MisterTi836/Voiture_commandes_gestuelles/README.md

# Voiture_commandes_gestuelles
Voiture télécommandé, controlé par des commandes gestuelles en Arduino
