MisterTi836/Voiture_commandes_gestuelles/Compte-rendus/Thibault GARROT/Rapport du 13-01.pdf

## Rapport du 13/01/2020 :

- Fin de l’initialisation des deux modules bluetooths.
Le HC-06 étant déjà configurer, je me suis chargé de paramétrer le HC-05.

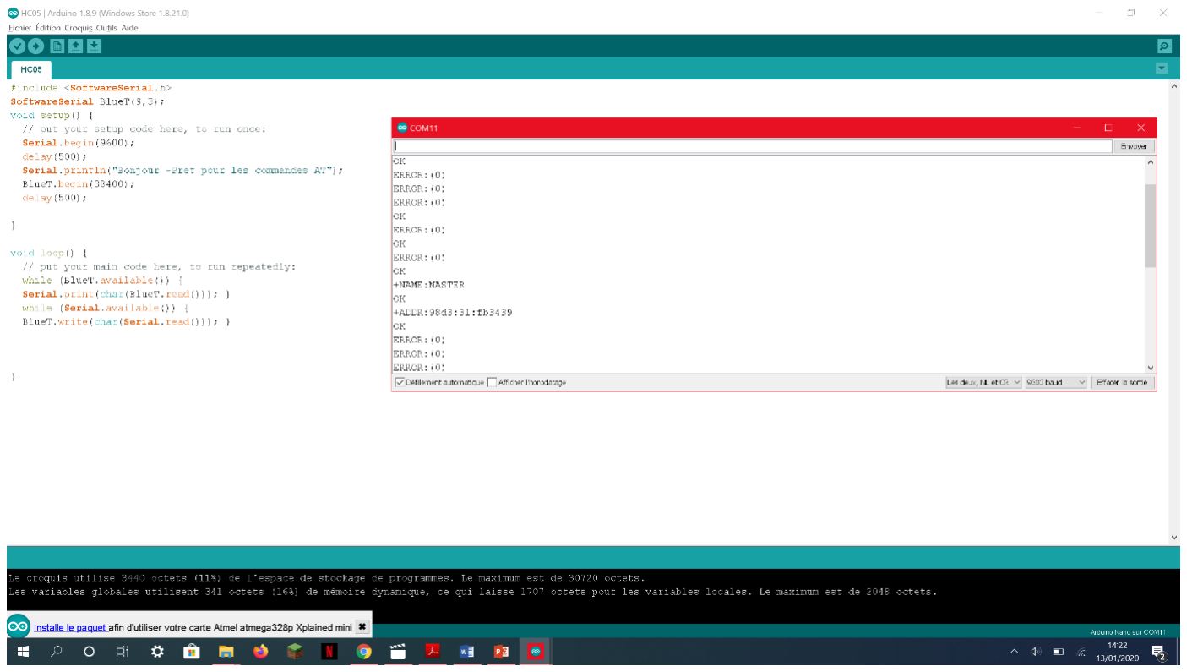
[picture p1: figure]

Code HC-05 initialisation.

- Problème pour la puissance des moteurs, les roues ne tournent pas assez vite. Test changement de piles et test du programme inefficace sur le problème. Devrait-on prendre des moteurs plus puissants ?

- Réalisation du programme de l’accéléromètre pour récupérer la valeur des angles sur x,y,z. J’ai pu calculer les angles sur les trois axes dans mon programme pour ensuite les afficher dans le moniteur série et pour ainsi tester les angles que me retourner l’accéléromètre. J’ai donc établi les 6 conditions d’angles nécessaires au déplacement de notre voiture avec le gant (décrit sur la feuille ci-dessous). Ces conditions pourront être améliorer pour établir des mouvements progressifs (accélération progressive etc…)

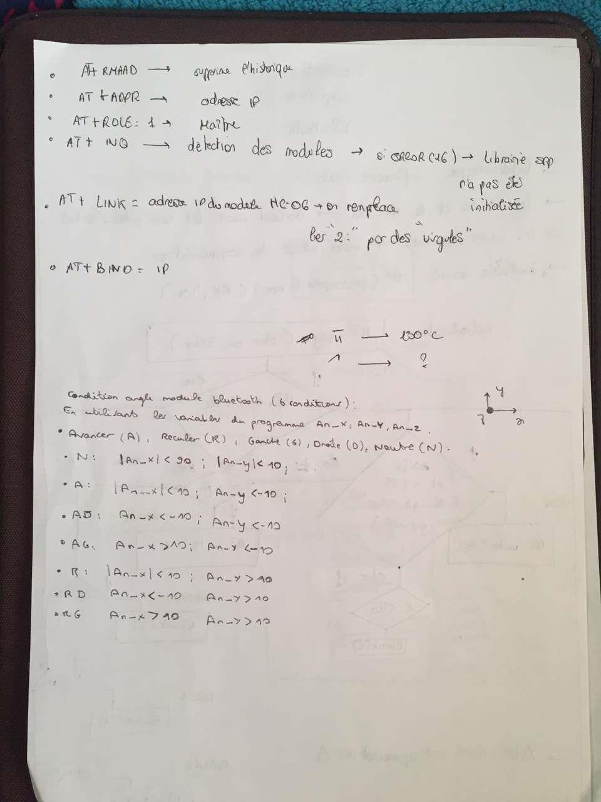
[picture p2: figure]

Tsiory lui s’est occupé principalement des algorithmes sur les connections bluetooth entre la voiture et le gant. Il s’est aussi charger des connections du lilypad (carte arduino pour le gant) que nous venons de recevoir.
