MisterTi836/Voiture_commandes_gestuelles/Compte-rendus/Tsiory RAZANAKOTO/RAZANAKOTO-1_rapport.pdf

## RAPPORT DE SEANCE DU 9/12/19

Lors de la 1ère séance je me suis chargé d’établir le plan et le diagramme pour fabriquer le gant et comment mettre les composants sur le gant, de même pour la voiture. En effet je devais réfléchir aux différents composants utiles pour pouvoir établir la connexion entre le gant et la voiture. Après mure réflexion avec l’aide mon binôme afin de comprendre la transmission des données depuis le gant, on utilisera donc 2 modules Bluetooth HC-O5 et HC-06 dont l’un sera maître et l’autre sera esclave. Le module Bluetooth maître va donc transmettre les données au module esclave qui lui recevra les données; les données seront telles que les données et les informations que le gyroscope va émettre. Ce plan est disponible sur notre GitHub pour plus d’informations (TRANSMISSION GANT).

Concernant la mise en place des composants sur la voiture, je me suis chargé d’étudier les différents branchements entre les différents composants : la connexion entre les 2 moteurs et le module L298N ; L’Arduino et le module Bluetooth ; L’Arduino et le module L298N ; et toutes les connexions VCC et GND. De même le plan est disponible sur notre GitHub pour plus d’informations (RECEPTION DES DONNEES).

De plus, pour le rôle du gyroscope, je me suis basé sur le cours disponible sur la page du professeur, afin de mieux comprendre son fonctionnement et les types de variables qu’elle renvoie (ex : angle de rotation, axe X, axe Y, axe Z, vitesse angulaire….).

Concernant mon associé, il s’est chargé de réfléchir à la disposition des matériaux sur la voiture et d’établir des schémas à petite échelle de notre voiture , et aux dimensions des matériaux (surtout le châssis et les roues) pour éviter la surcharge de poids pour la voiture, ou encore la répartition de manière homogène de tous les composants sur la voiture.

Voici des aperçus des documents cités ci-dessus :

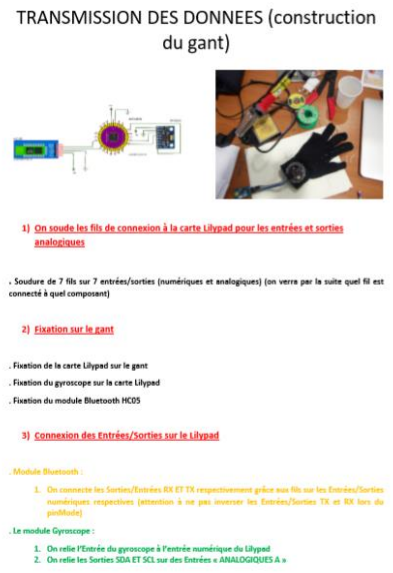
[picture p3: figure]
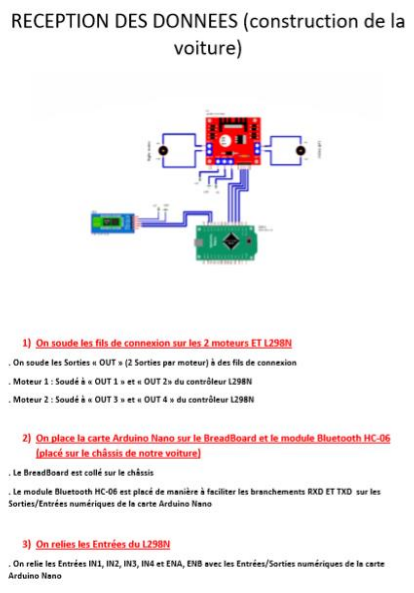
[picture p4: figure]
