MisterTi836/Voiture_commandes_gestuelles/Compte-rendus/Thibault GARROT/Rapport du 09-12.pdf

# Rapport du 09/12/2019 :

- Réflexion pour la fabrication :

Nous avons enfin pu définir tous les composants nécessaire pour la voiture :

-2 roues motrices

-2 roulettes( une de chaque coté, à l’endroit et à l’envers)

-2 moteurs

-Module bluetooth (HC-06)

-Le gyroscope

-Carte Arduino

-Breadboard

-L298N

Pour la roue, j’ai pu définir les contraintes qu’il faut respecter :

La hauteur des roues doit être supérieure à la hauteur de la disposition de composants de la voiture. Pareil pour les roulettes.

Les roulettes(+ châssis) peuvent avoir une taille supérieur au diamètre des roues.

-Diamètre min : 9cm

-Pneus suffisamment adhérents (pour la retourner)

Et aussi pour les moteurs :

Le moteur a une tige des deux côtés, il faut le prendre en compte lors de la fabrication du châssis, c’est-à-dire laisser une encoche.

- Récupération de matériels.
- Commande du matériel manquant.
- Tsiory s’est chargé d’établir le plan pour réaliser le gant ainsi que la communication entre le gant et la voiture.

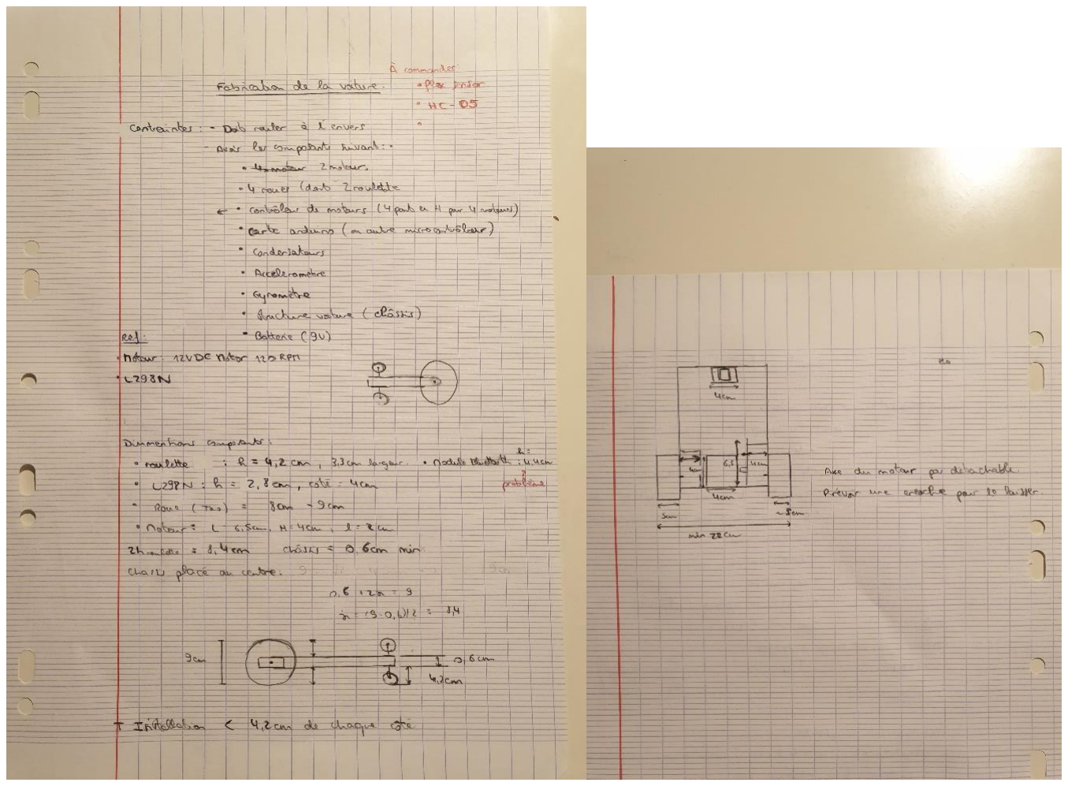
[picture p5: figure]
