MisterTi836/Voiture_commandes_gestuelles/Diagramme de Gant.pptx

Recherche communication gant/voiture

Réflexion fabrication voiture

Recherche idée pour retourner la voiture(code/composants)

Dec 9 - Dec 15

Dec 9 - Dec 15

Dec 9 - Dec 15

Fabrication de la voiture

Dec 16 - Jan 5

Code pour les mouvements élémentaire de la voiture( test téléphone en bluetooth)

Code du gant( accéléromètre/flex sensor)

Fabrication gant

Dec 16 - Jan 5

Dec 30 - Jan 12

Dec 30 - Jan 12

Finalisation du code pour le contrôle total de la voiture avec le gant.

Code communication voiture/gant

Jan 11 - Jan 17

Jan 20 - Jan 26

Ajout code mouvements supplémentaires

Jan 13

Dec

Today

2020

2020
