MisterTi836/Voiture_commandes_gestuelles/Compte-rendus/Thibault GARROT/Rapport du 16-12.pdf

## Rapport du 16/12/2019 :

- Construction de la voiture :

Nous avons trouvé une autre idée pour la construction de la voiture, qui consiste à coller les 2 moteurs entre deux planches de bois. Comme ceci, les roues sont centrées avec le niveau des roulettes, de façon à ce que la voiture soit dans la même position à l’endroit et à l’envers.

Avec cette méthode, plus de problèmes pour la disposition des composants.

Découpage des deux planches, fixation des roulettes.

- Lecture de la documentation sur l’accéléromètre
- Tsiory a réalisé le soudage des fils pour les moteurs, ainsi que les tests des moteurs pour vérifier leurs fonctionnements avec les piles( 4*1.5V) .
