MisterTi836/Voiture_commandes_gestuelles/(commit log)

2019-12-08 Add files via upload
    Cahier des charges
2019-12-10 Rapports de séances/
2020-03-16 Erreur du 1er compte rendu
    Veuillez nous excuser pour le premier rapport, il y a eu une erreur d'affichage au niveau du pdf, nous vous le renvoyons ici même.
    Merci de votre compréhension.
